spiwocoal/547452/img/pcb3d-1.png

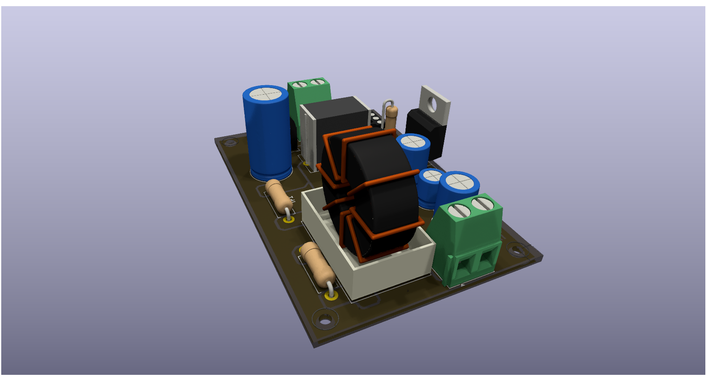
img/pcb3d-1.png
