spiwocoal/547452/img/pcb3d-2.png

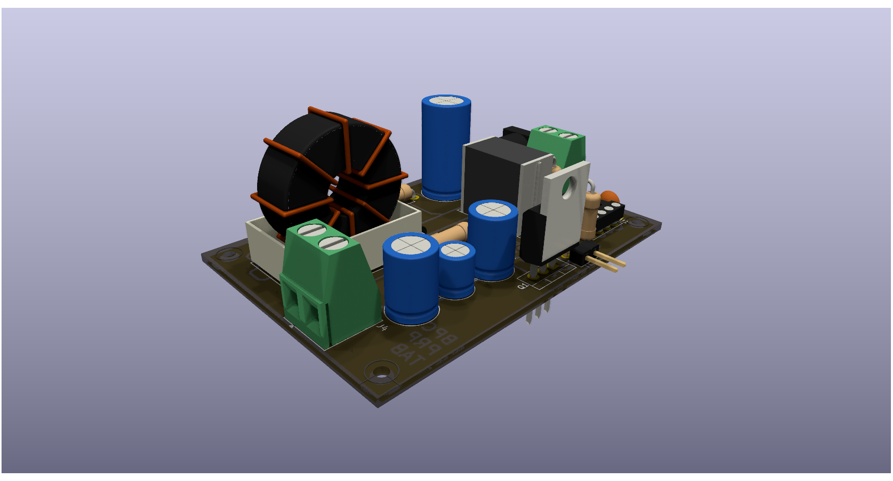
img/pcb3d-2.png
