spiwocoal/547452/esp-src/dpp-qr.png

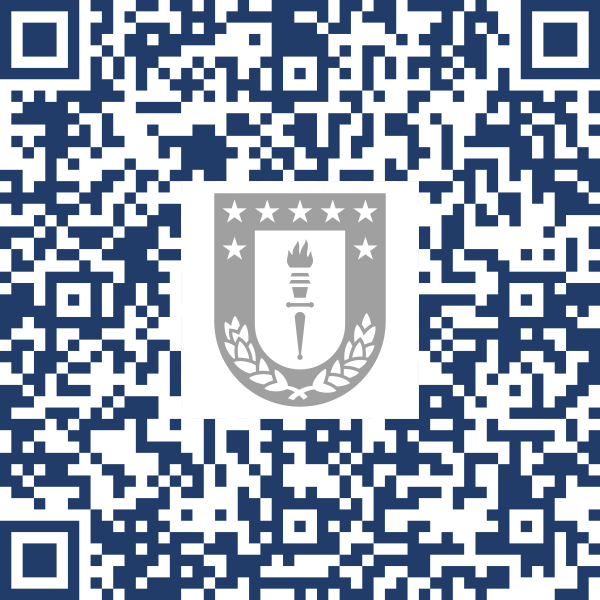
esp-src/dpp-qr.png
