spiwocoal/547452/img/gui.png

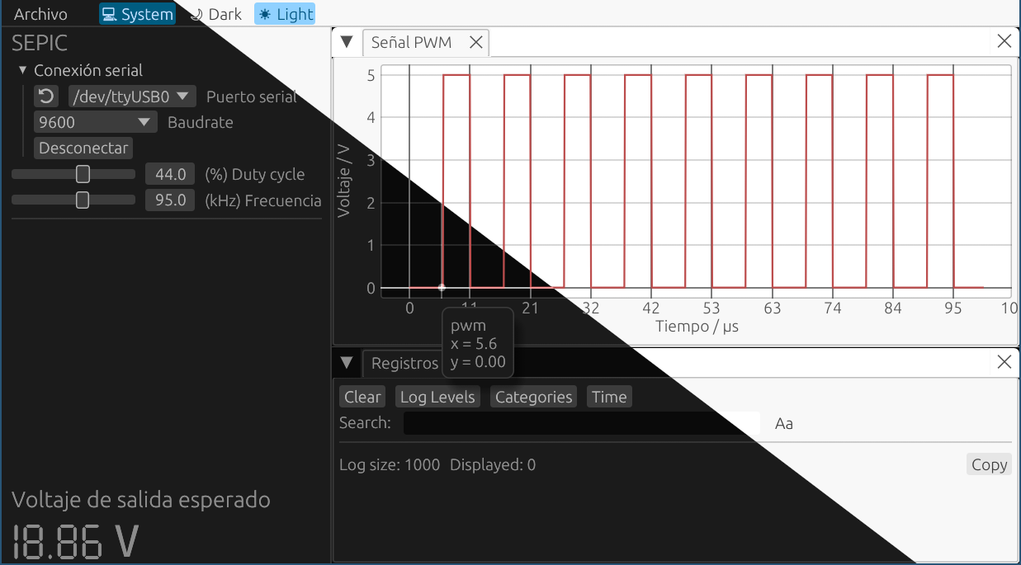
img/gui.png
