spiwocoal/547452/img/pcb3d-3.png

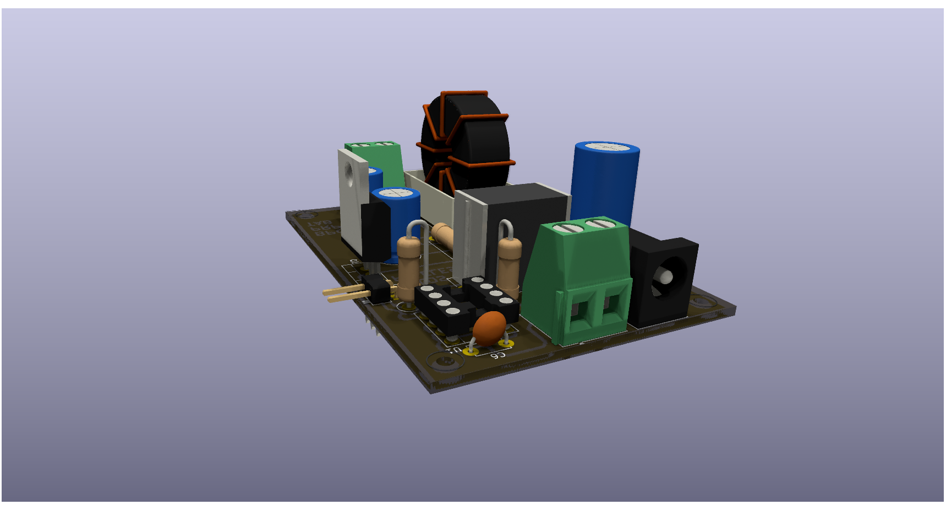
img/pcb3d-3.png
