spiwocoal/547452/img/pcb3d-4.png

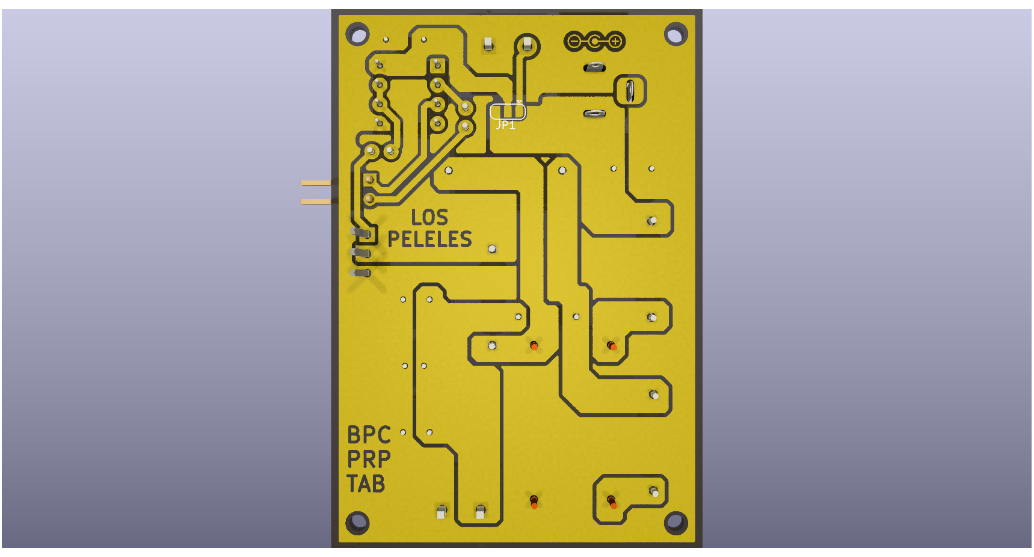
img/pcb3d-4.png
