spiwocoal/547452/spice/plots/duty_ideal.png

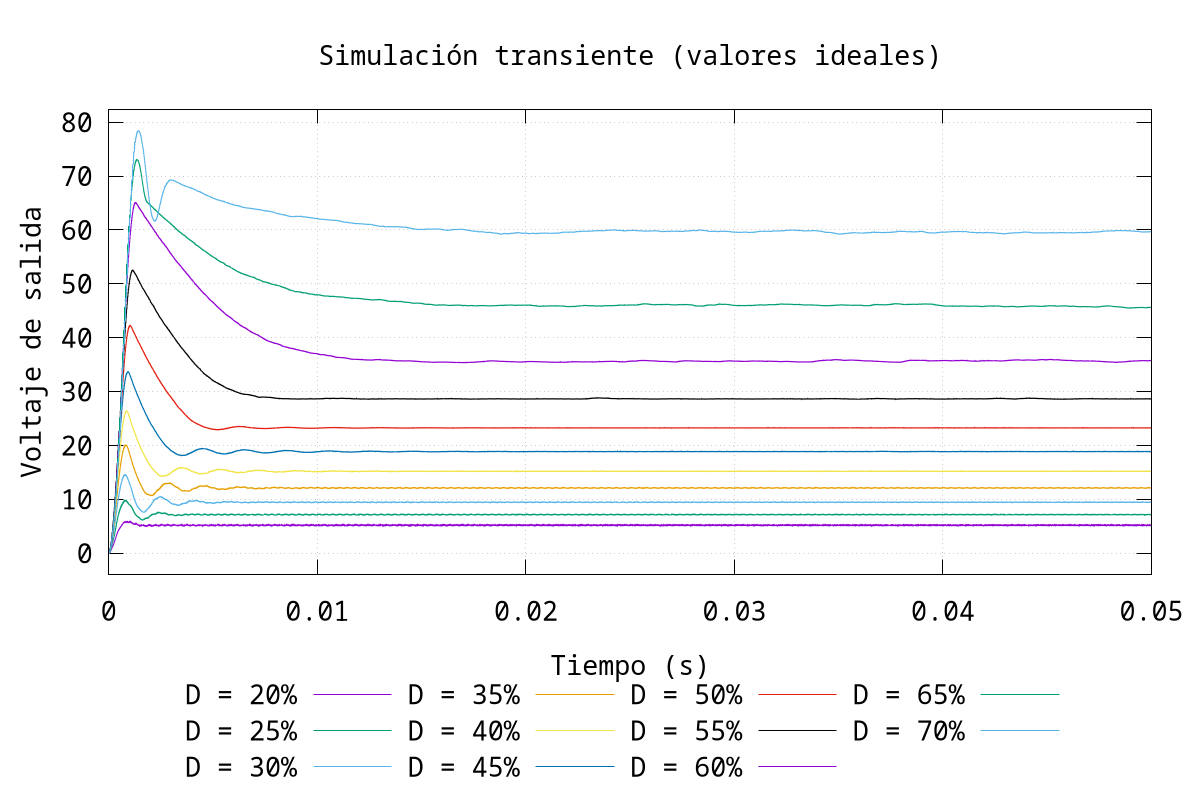
spice/plots/duty_ideal.png
