spiwocoal/547452/spice/plots/duty_med.png

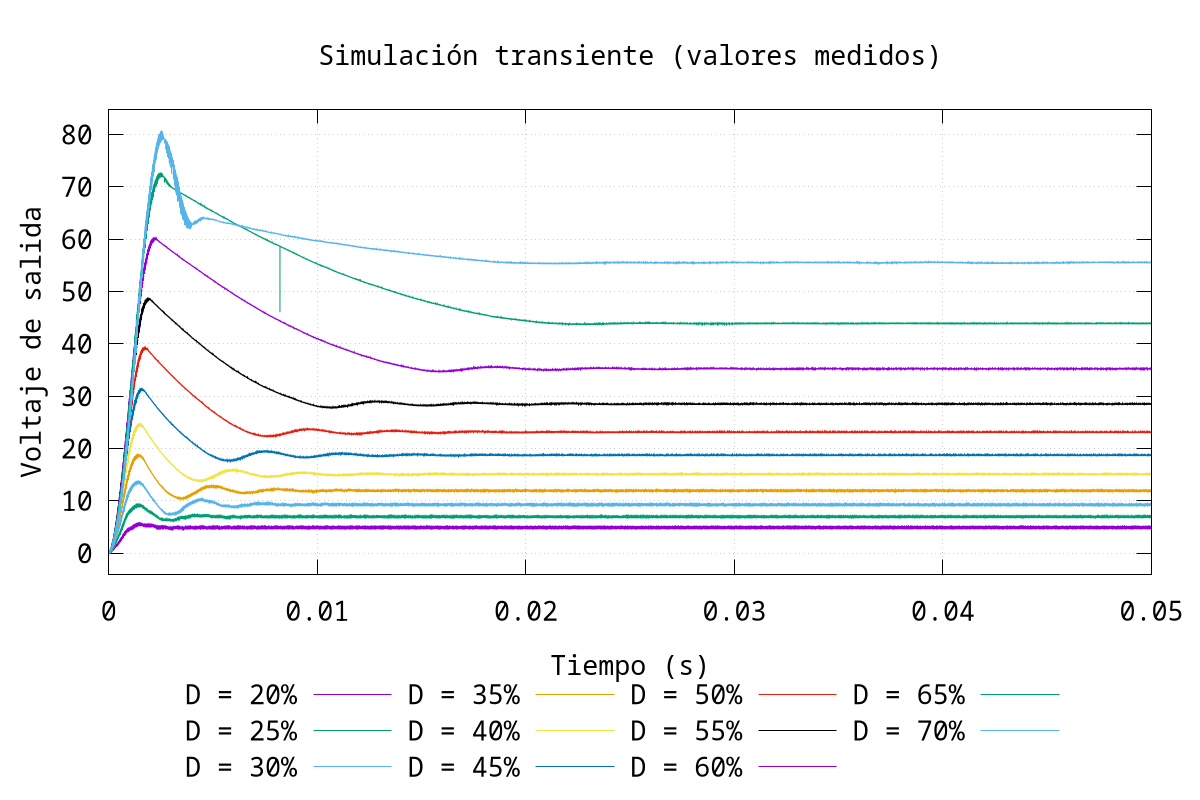
spice/plots/duty_med.png
