spiwocoal/547452/coil-former/airgap-02.stl

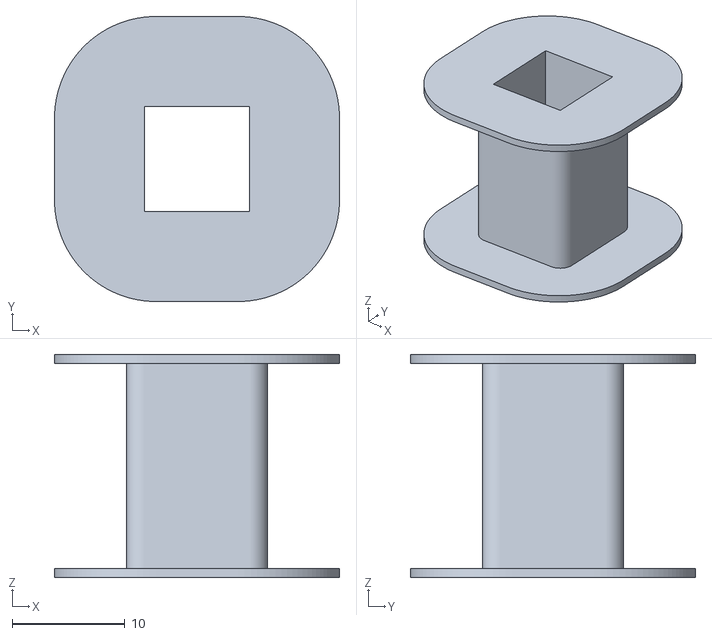
[picture p10: CAD file, 2025-10-09]
coil-former/airgap-02.stl
25.3 x 25.3 x 19.8
