spiwocoal/547452/epicSEPIC/3d-model/enclosure.stl

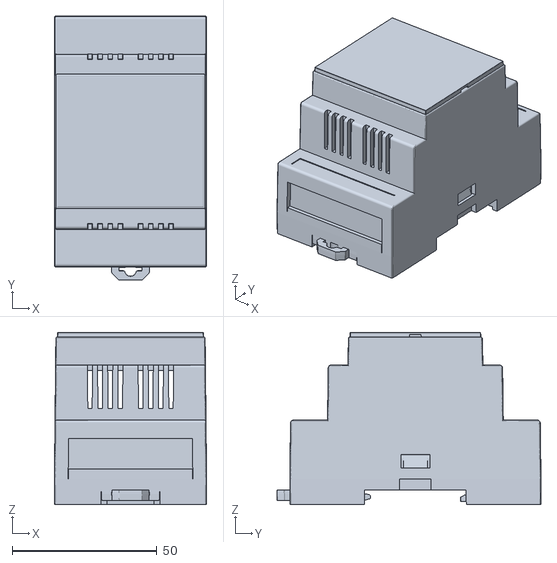
[picture p11: CAD file, 2025-12-04]
epicSEPIC/3d-model/enclosure.stl
52.6 x 91.2 x 59.5
