spiwocoal/547452/SEPIC/gerber/SEPIC-drl_map.dxf

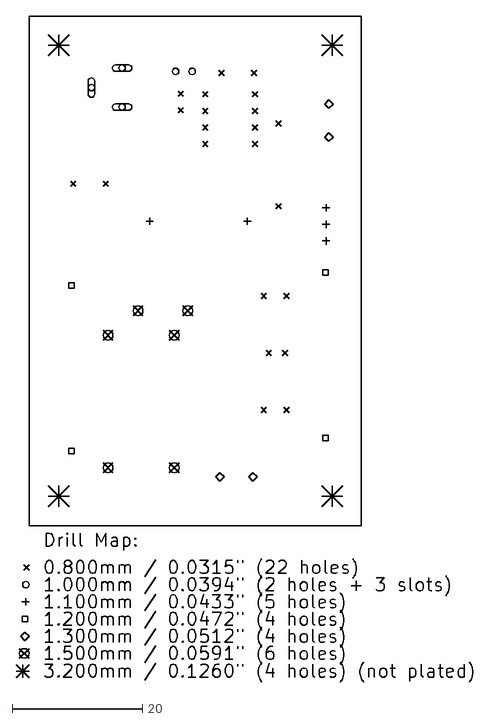
[picture p12: CAD file, 2025-10-24]
SEPIC/gerber/SEPIC-drl_map.dxf
70.1 x 102.3
