spiwocoal/547452/coil-former/split-airgap-02.stl

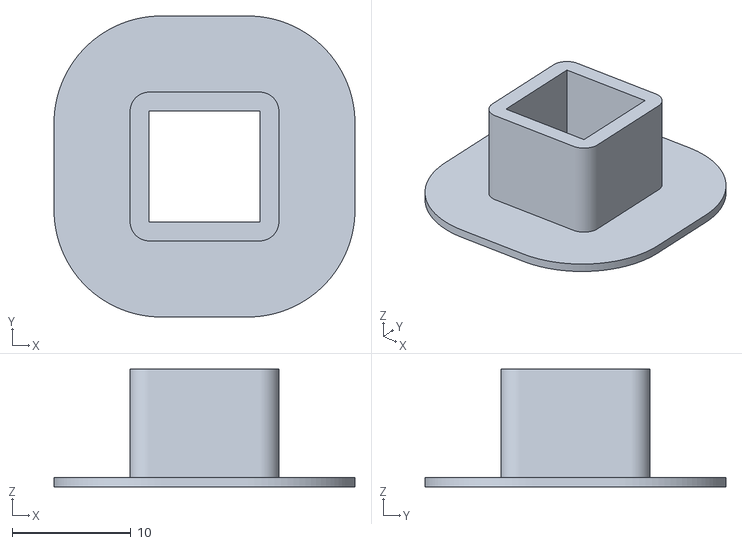
[picture p13: CAD file, 2025-10-09]
coil-former/split-airgap-02.stl
25.3 x 25.3 x 9.90
