spiwocoal/547452/coil-former/split-airgap-04.stl

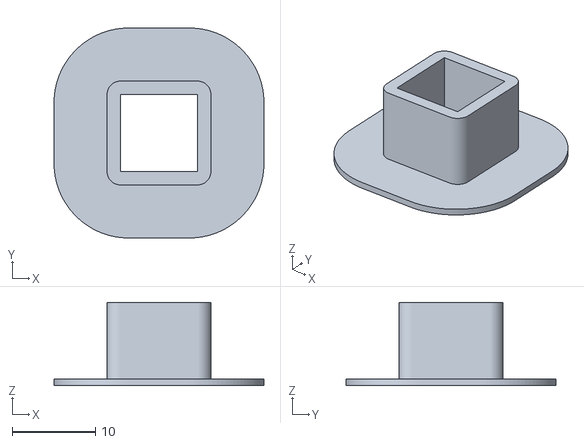
[picture p14: CAD file, 2025-10-09]
coil-former/split-airgap-04.stl
25.3 x 25.3 x 10.00
