spiwocoal/547452/coil-former/split-airgap-0.stl

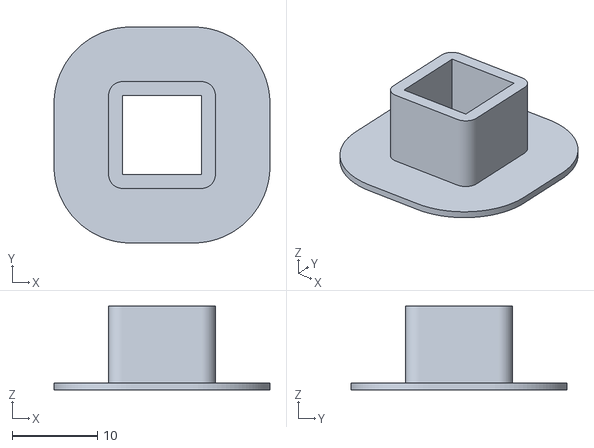
[picture p15: CAD file, 2025-10-09]
coil-former/split-airgap-0.stl
25.3 x 25.3 x 9.80
