spiwocoal/547452/coil-former/airgap-04.stl

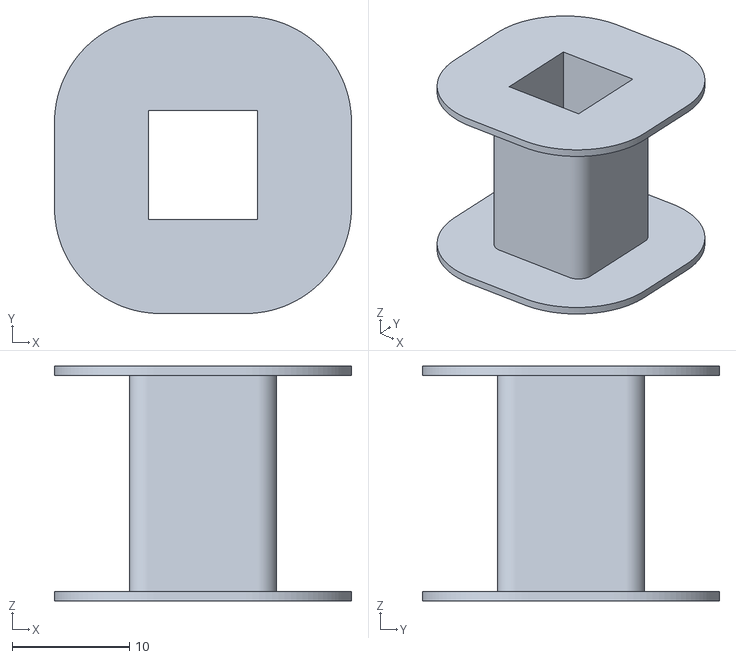
[picture p16: CAD file, 2025-10-09]
coil-former/airgap-04.stl
25.3 x 25.3 x 20.0
