spiwocoal/547452/coil-former/split-airgap-06.stl

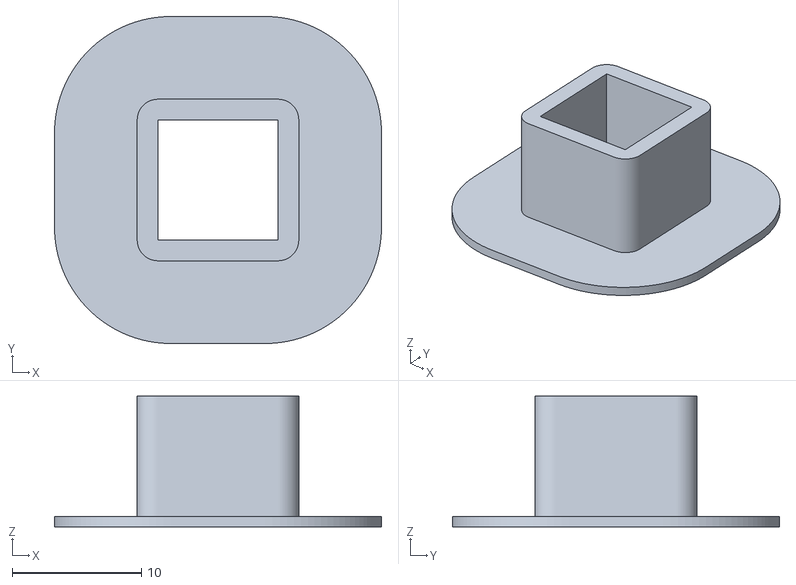
[picture p17: CAD file, 2025-10-09]
coil-former/split-airgap-06.stl
25.3 x 25.3 x 10.1
