spiwocoal/547452/(list of files, cad)

Other CAD files:
coil-former/airgap-0.stl
coil-former/airgap-06.stl
