spiwocoal/547452/schematic.pdf

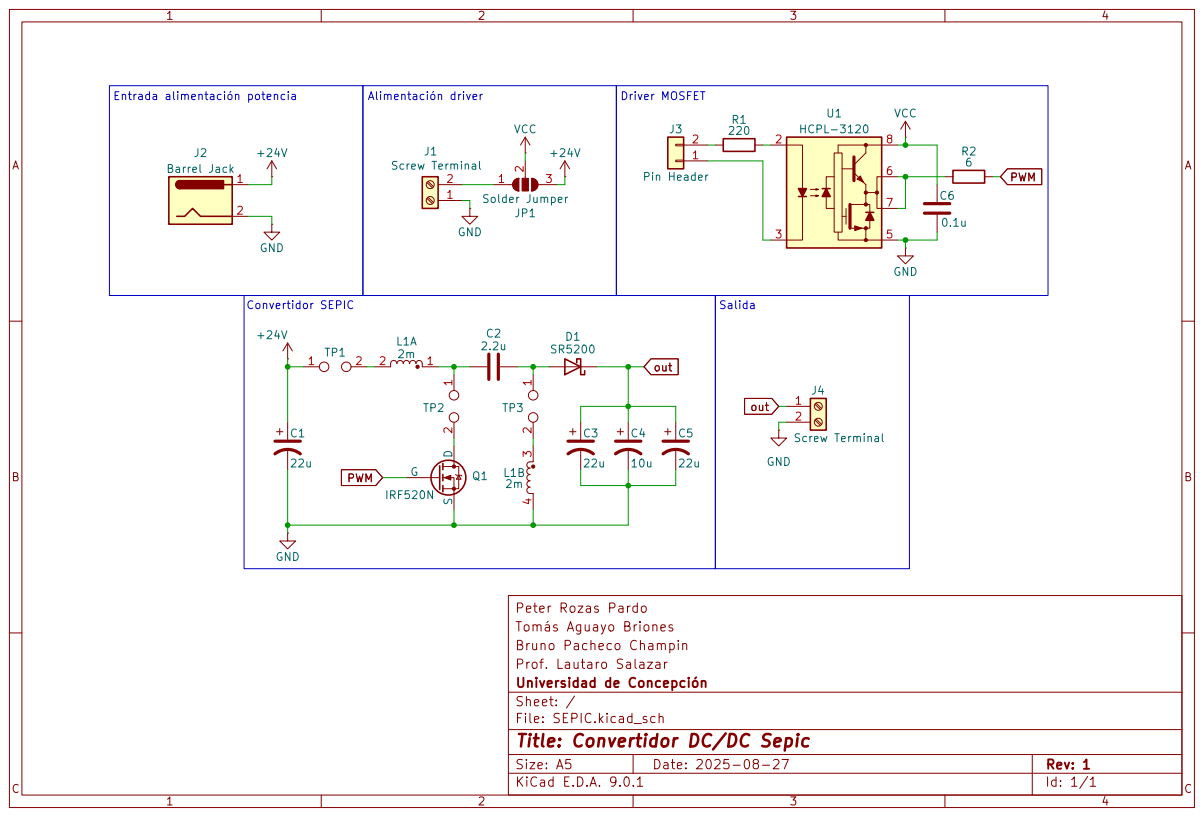
[picture p18: page 1]
