spiwocoal/547452/epicSEPIC/epicSEPIC.kicad_pcb

## KiCad design epicSEPIC/epicSEPIC.kicad_pcb (2025-12-18)

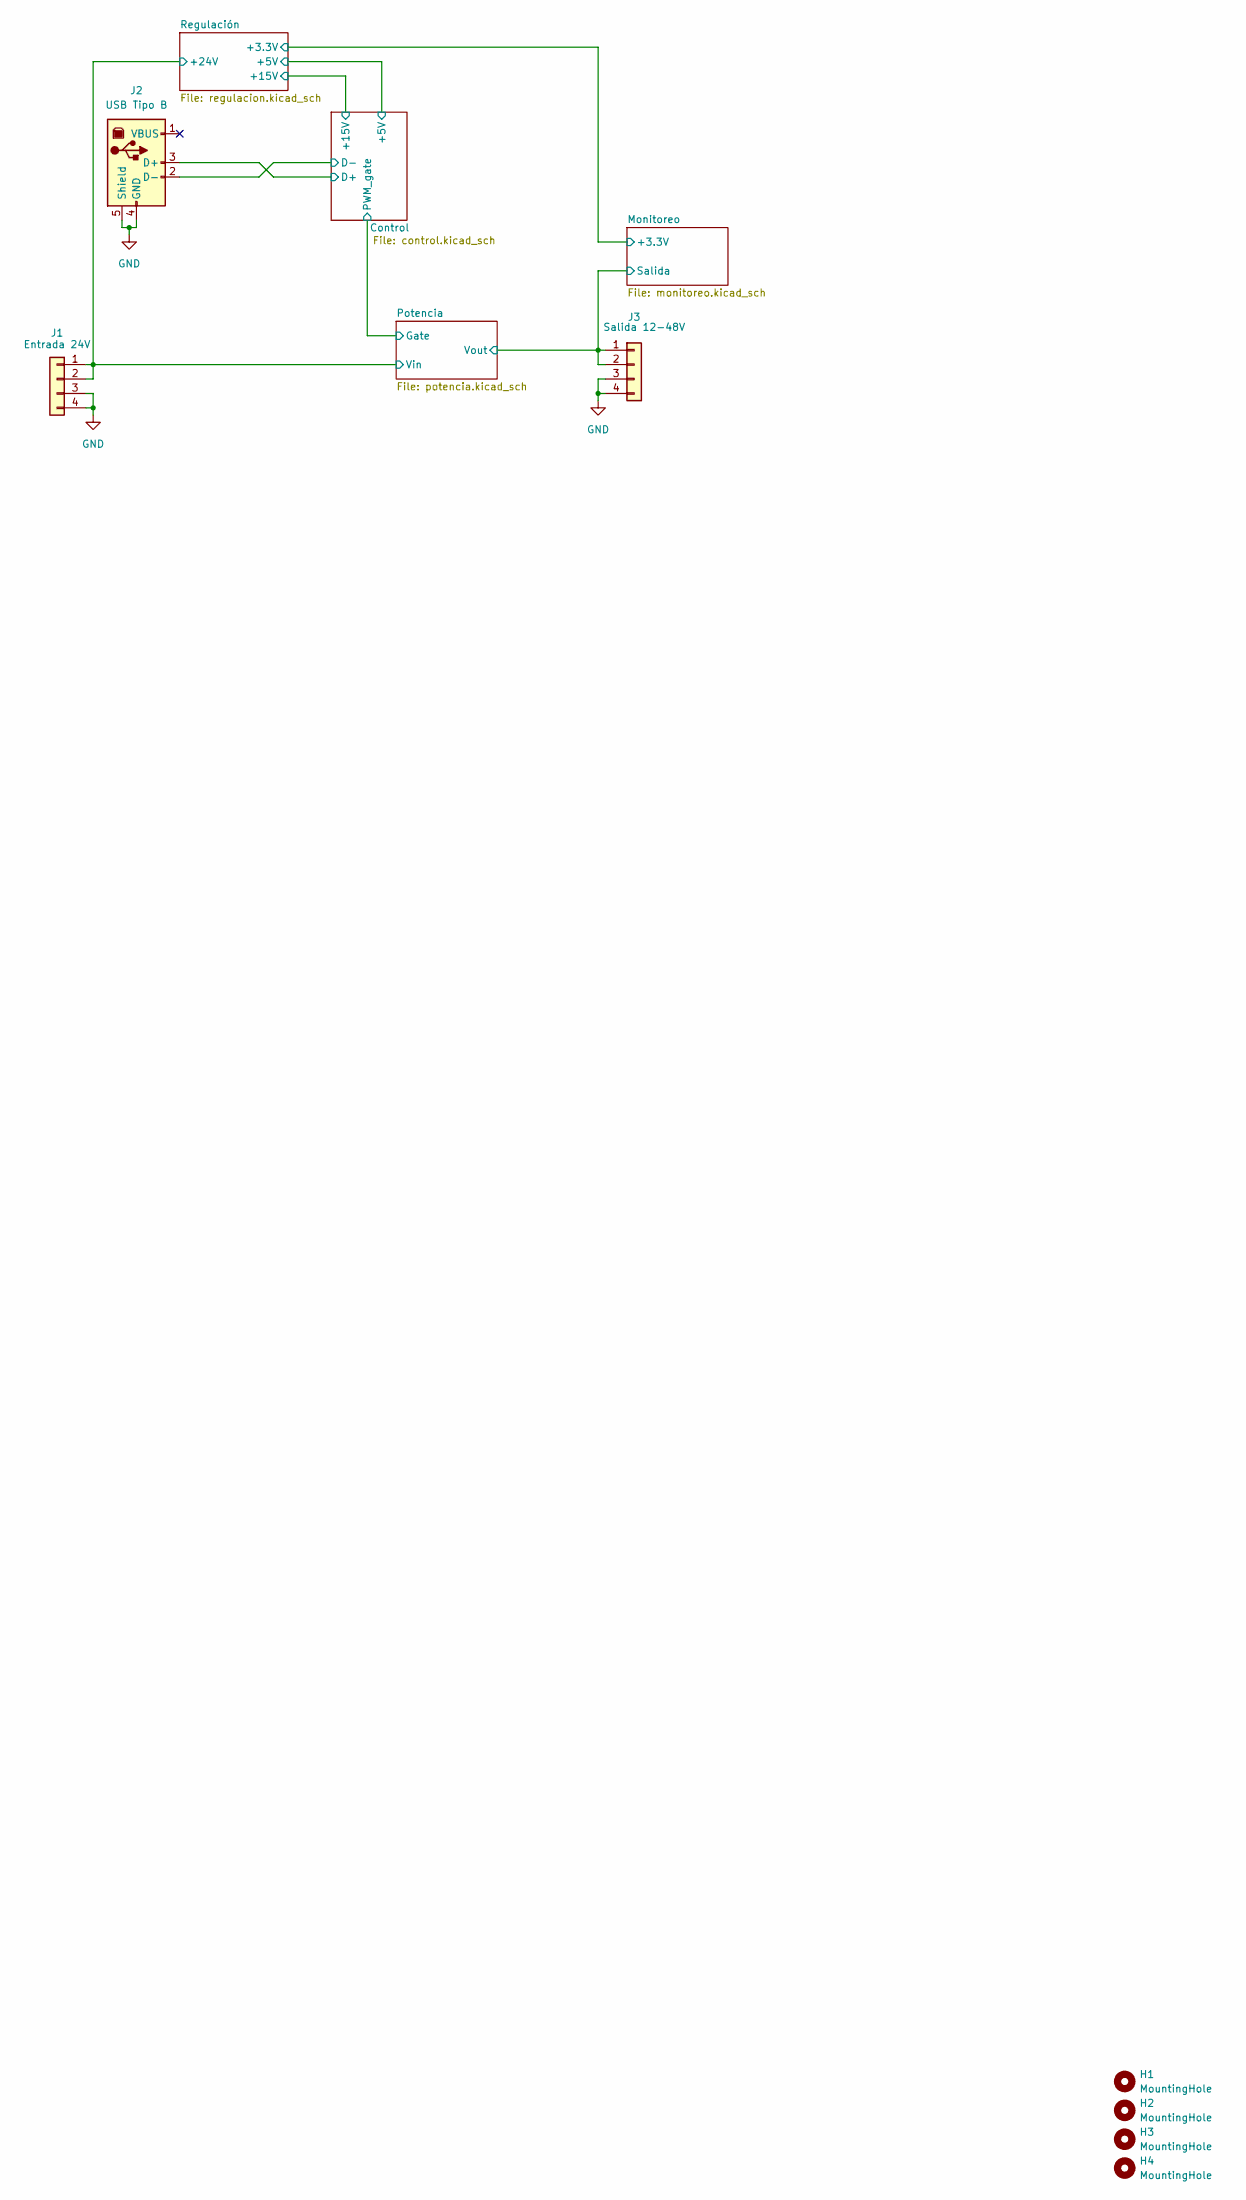
[picture p19: schematic epicSEPIC.kicad_sch]

Parts:
H1, H2, H3, H4: MountingHole; MountingHole_3.2mm_M3_ISO14580
J1: Entrada 24V; 1822752; MfgPN 1823638
J2: USB Tipo B; USB_B_Lumberg_2411_02_Horizontal; MfgPN 61729-0010RLF
J3: Salida 12-48V; 1822752; MfgPN 1823638

Connections:
/Control/D+: J2.3 (D+); also elsewhere on the board
/Control/D-: J2.2 (D-); also elsewhere on the board
/Monitoreo/Salida: J3.1, J3.2; also elsewhere on the board
/Potencia/Vin: J1.1, J1.2; also elsewhere on the board
GND: J1.3, J1.4, J2.4 (GND), J2.5 (Shield), J3.3, J3.4; also elsewhere on the board

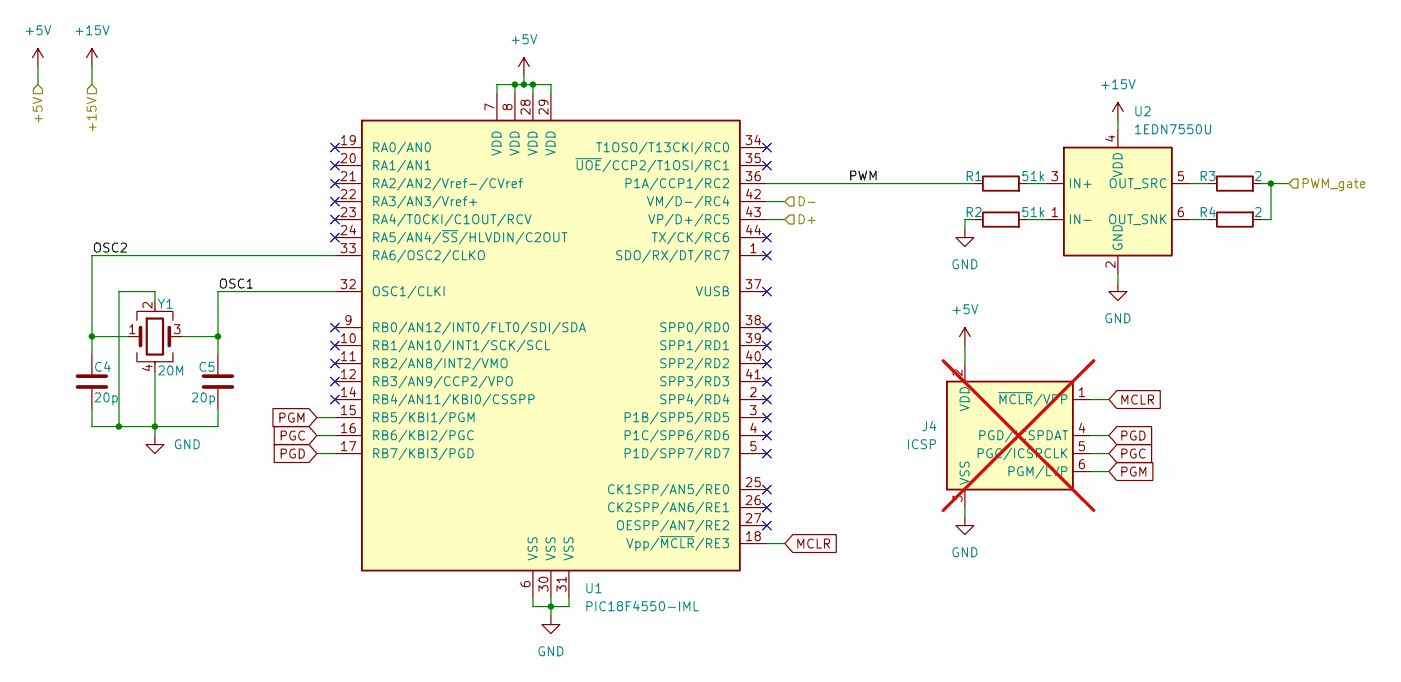
[picture p20: schematic control.kicad_sch]

Parts:
C4, C5: 20p; C_0402_1005Metric; MfgPN C0402C200M8HACTU
J4: ICSP; PinSocket_1x06_P1.00mm_Vertical; not fitted
R1, R2: 51k; R_0603_1608Metric; MfgPN ESR03EZPD5102
R3, R4: 2; R_0402_1005Metric; MfgPN RT0402BRE072RL
U1: PIC18F4550-IML; QFN-44-1EP_8x8mm_P0.65mm_EP6.45x6.45mm; MfgPN PIC18F4550-IML
U2: 1EDN7550U; PG-TSNP-6-13; MfgPN 1EDN7550U
Y1: 20M; Crystal_SMD_2520-4Pin_2.5x2.0mm; MfgPN FH2000021

Connections:
+5V: J4.2 (VDD), U1.7 (VDD), U1.8 (VDD), U1.28 (VDD), U1.29 (VDD); also elsewhere on the board
+15V: U2.4 (VDD); also elsewhere on the board
/Control/D+: U1.43 (VP/D+/RC5); also elsewhere on the board
/Control/D-: U1.42 (VM/D-/RC4); also elsewhere on the board
/Control/OSC1: C5.2, U1.32 (OSC1/CLKI), Y1.3
/Control/OSC2: C4.1, U1.33 (RA6/OSC2/CLKO), Y1.1
/Control/PWM: R1.1, U1.36 (P1A/CCP1/RC2)
/Control/PWM_gate: R3.2, R4.2; also elsewhere on the board
GND: C4.2, C5.1, J4.3 (VSS), R2.1, U1.6 (VSS), U1.30 (VSS), U1.31 (VSS), U2.2 (GND), Y1.2, Y1.4; also elsewhere on the board
MCLR: J4.1 (~MCLR/VPP), U1.18 (Vpp/~MCLR/RE3)
unnamed: R1.2, U2.3 (IN+)
unnamed: R2.2, U2.1 (IN-)
unnamed: R4.1, U2.6 (OUT_SNK)
unnamed: R3.1, U2.5 (OUT_SRC)
PGC: J4.5 (PGC/ICSPCLK), U1.16 (RB6/KBI2/PGC)
PGD: J4.4 (PGD/ICSPDAT), U1.17 (RB7/KBI3/PGD)
PGM: J4.6 (PGM/LVP), U1.15 (RB5/KBI1/PGM)

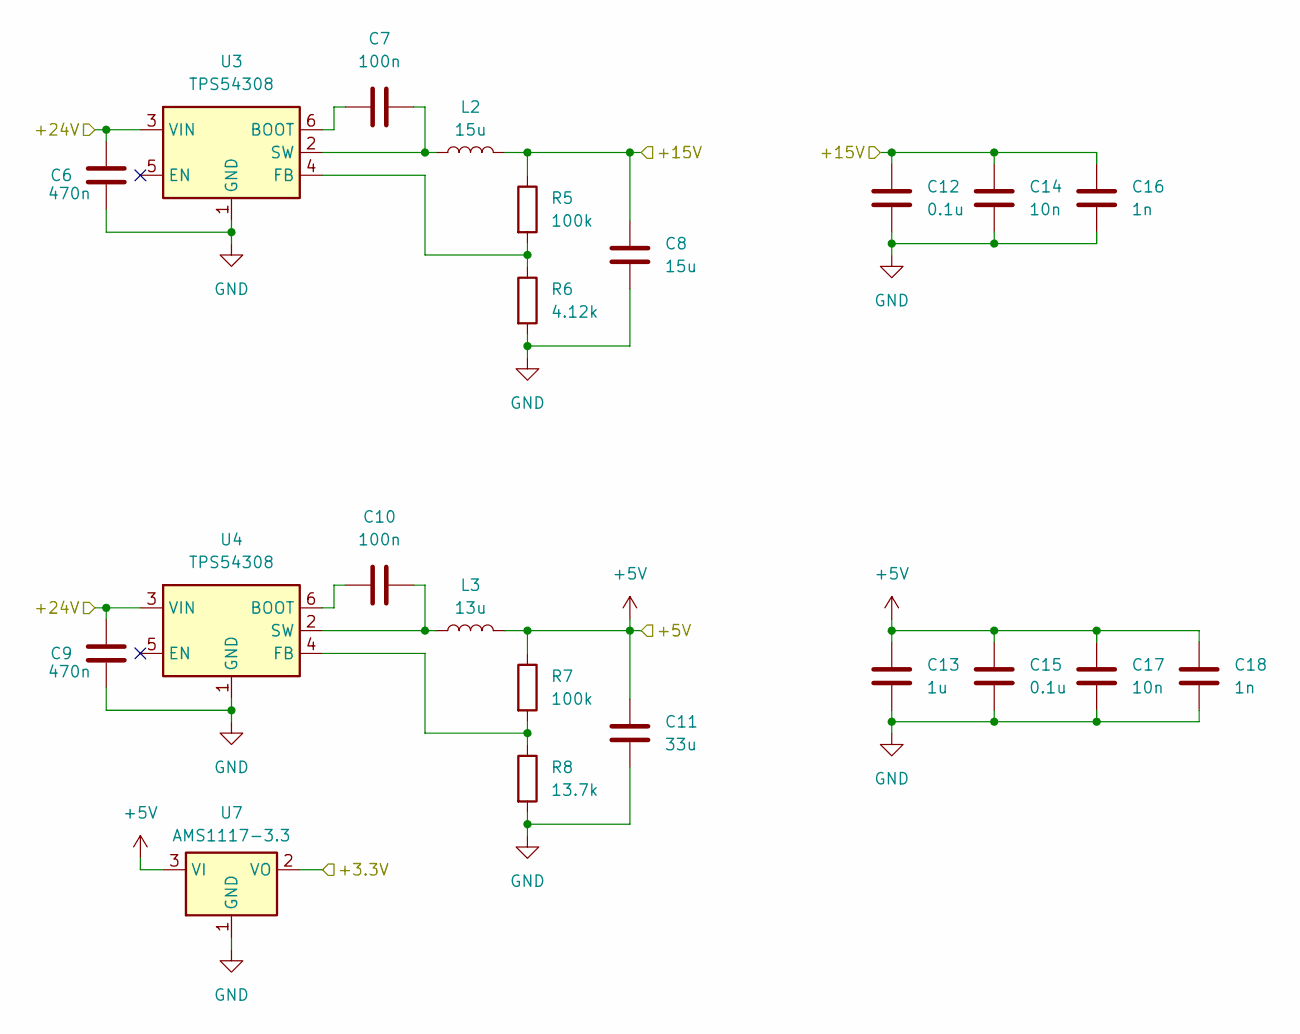
[picture p21: schematic regulacion.kicad_sch]

Parts:
C6, C9: 470n; C_0603_1608Metric; MfgPN CGA3E3X5R1V474K080AB
C7, C10: 100n; C_0402_1005Metric; MfgPN C1005X7R1H104K050BB
C8: 15u; C_0805_2012Metric; MfgPN C2012X5R1V156M125AC
C11: 33u; C_0805_2012Metric; MfgPN C2012X5R1A336M125AC
C12: 0.1u; C_0805_2012Metric; MfgPN C0805C104M4RACTU
C13: 1u; C_0805_2012Metric; MfgPN C0805C105M8RACTU
C14: 10n; C_0603_1608Metric; MfgPN C0603C103M4RACTU
C15: 0.1u; C_0805_2012Metric; MfgPN C0805C104M8RACTU
C16: 1n; C_0402_1005Metric; MfgPN C0402C102M4RACTU
C17: 10n; C_0603_1608Metric; MfgPN C0603C103M8RACTU
C18: 1n; C_0402_1005Metric; MfgPN C0402C102M8RACTU
L2: 15u; L_Wurth_WE-LHMI-7050; MfgPN 74437349150
L3: 13u; L_Wurth_WE-PDF-1064; MfgPN 7447798131
R5, R7: 100k; R_0402_1005Metric; MfgPN CRCW0402100KFKED
R6: 4.12k; R_0402_1005Metric; MfgPN CRCW04024K12FKED
R8: 13.7k; R_0402_1005Metric; MfgPN CRCW040213K7FKED
U3, U4: TPS54308; SOT-23-6; MfgPN TPS54308
U7: AMS1117-3.3; SOT-223-3_TabPin2

Connections:
+3.3V: U7.2 (VO); also elsewhere on the board
+5V: C11.2, C13.1, C15.1, C17.1, C18.1, L3.2, R7.1, U7.3 (VI); also elsewhere on the board
+15V: C8.2, C12.1, C14.1, C16.1, L2.2, R5.1; also elsewhere on the board
/Potencia/Vin: C6.1, C9.1, U3.3 (VIN), U4.3 (VIN); also elsewhere on the board
GND: C6.2, C8.1, C9.2, C11.1, C12.2, C13.2, C14.2, C15.2, C16.2, C17.2, C18.2, R6.2, R8.2, U3.1 (GND), U4.1 (GND), U7.1 (GND); also elsewhere on the board
unnamed: C7.1, U3.6 (BOOT)
unnamed: R5.2, R6.1, U3.4 (FB)
unnamed: C7.2, L2.1, U3.2 (SW)
unnamed: C10.1, U4.6 (BOOT)
unnamed: R7.2, R8.1, U4.4 (FB)
unnamed: C10.2, L3.1, U4.2 (SW)

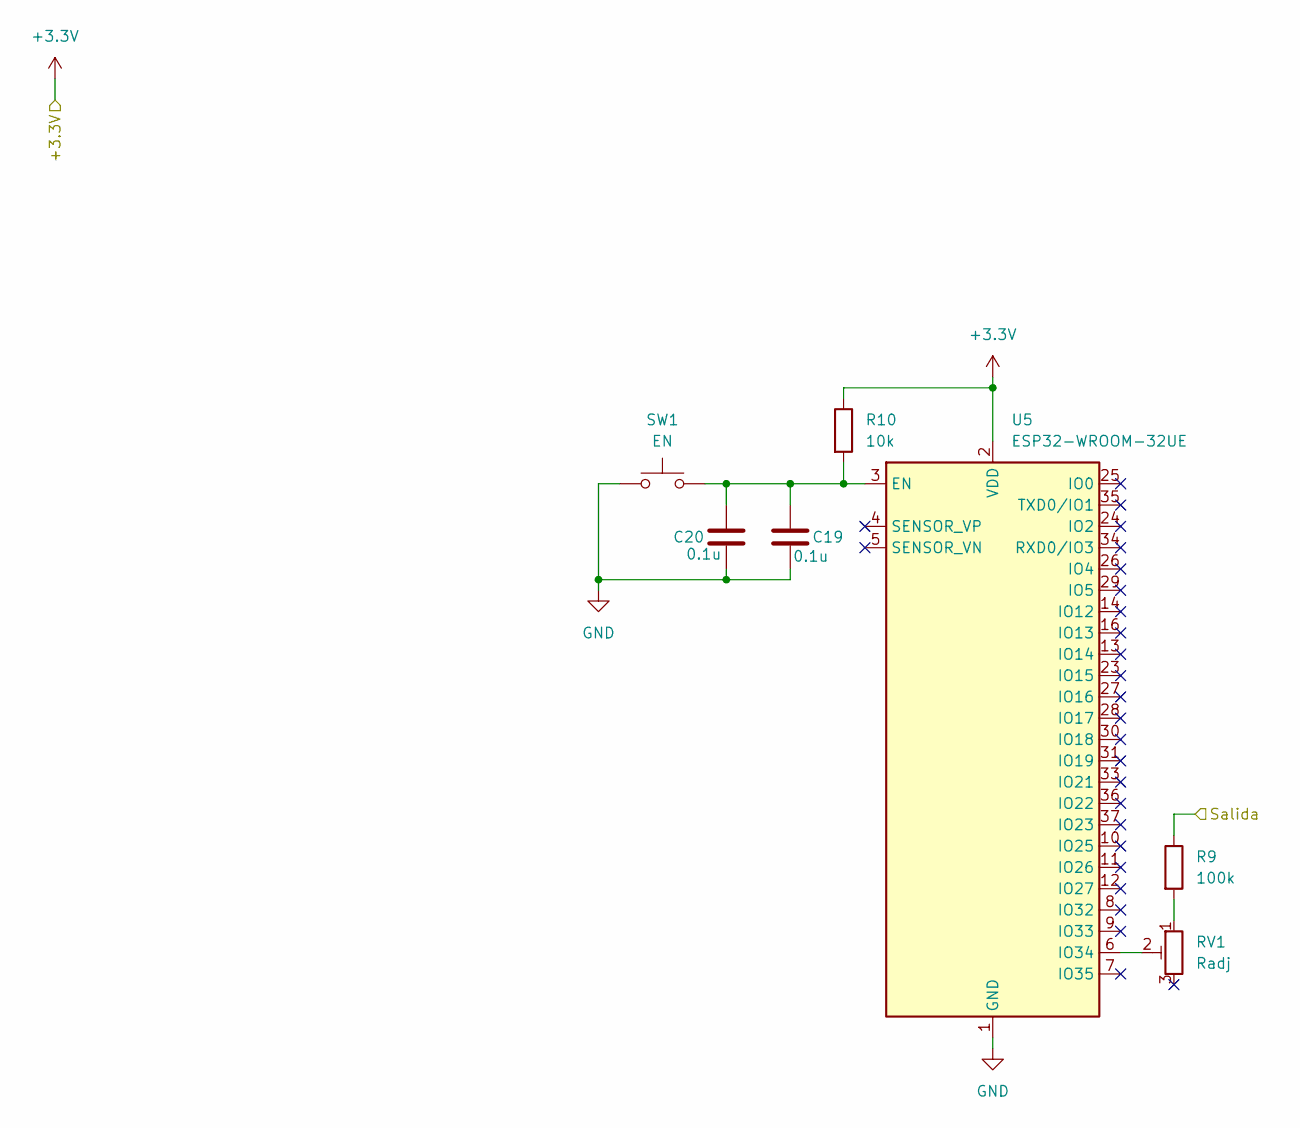
[picture p22: schematic monitoreo.kicad_sch]

Parts:
C19, C20: 0.1u; C_0201_0603Metric
R9: 100k; R_0201_0603Metric
R10: 10k; R_0201_0603Metric
RV1: Radj; 3313J1102E
SW1: EN; SW_SPST_B3U-1000P-B
U5: ESP32-WROOM-32UE

Connections:
+3.3V: R10.1, U5.2 (VDD); also elsewhere on the board
/Monitoreo/Salida: R9.1; also elsewhere on the board
GND: C19.2, C20.2, SW1.1, U5.1 (GND), U5.15 (GND), U5.38 (GND), U5.39 (GND); also elsewhere on the board
unnamed: R9.2, RV1.1
unnamed: C19.1, C20.1, R10.2, SW1.2, U5.3 (EN)
unnamed: RV1.2, U5.6 (IO34)

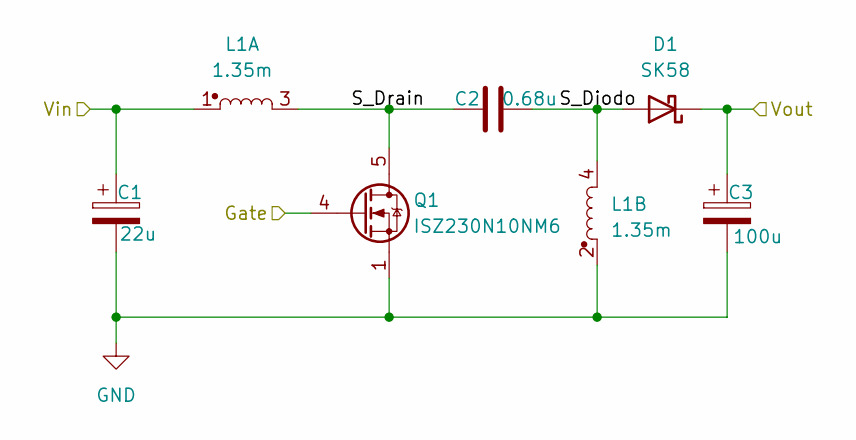
[picture p23: schematic potencia.kicad_sch]

Parts:
C1: 22u; CP_Elec_8x10; MfgPN A767KN226M1HLAE050
C2: 0.68u; C_1206_3216Metric; MfgPN C1206C684M1RACTU
C3: 100u; CP_Elec_10x12.5; MfgPN A767MU107M1JLAE28
D1: SK58; D_SMB; MfgPN SK58
L1: 1.35m; SRF1280680M; MfgPN SRF1280-680M
Q1: ISZ230N10NM6; PG-TSDSON-8-25; MfgPN ISZ230N10NM6ATMA1

Connections:
/Control/PWM_gate: Q1.4 (G); also elsewhere on the board
/Monitoreo/Salida: C3.1, D1.1 (K); also elsewhere on the board
/Potencia/S_Diodo: C2.2, D1.2 (A), L1.4
/Potencia/S_Drain: C2.1, L1.3, Q1.5 (D)
/Potencia/Vin: C1.1, L1.1; also elsewhere on the board
GND: C1.2, C3.2, L1.2, Q1.1 (S); also elsewhere on the board

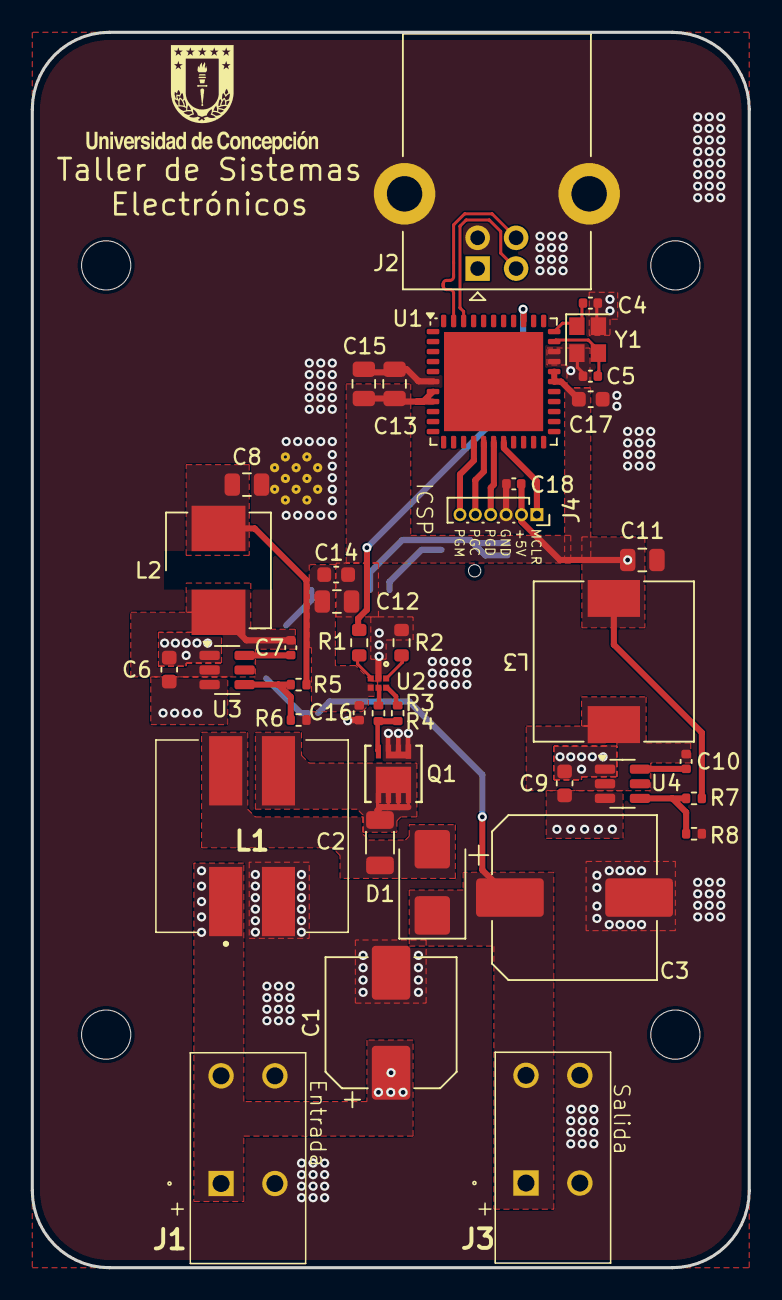
[picture p24: board epicSEPIC.kicad_pcb from above]

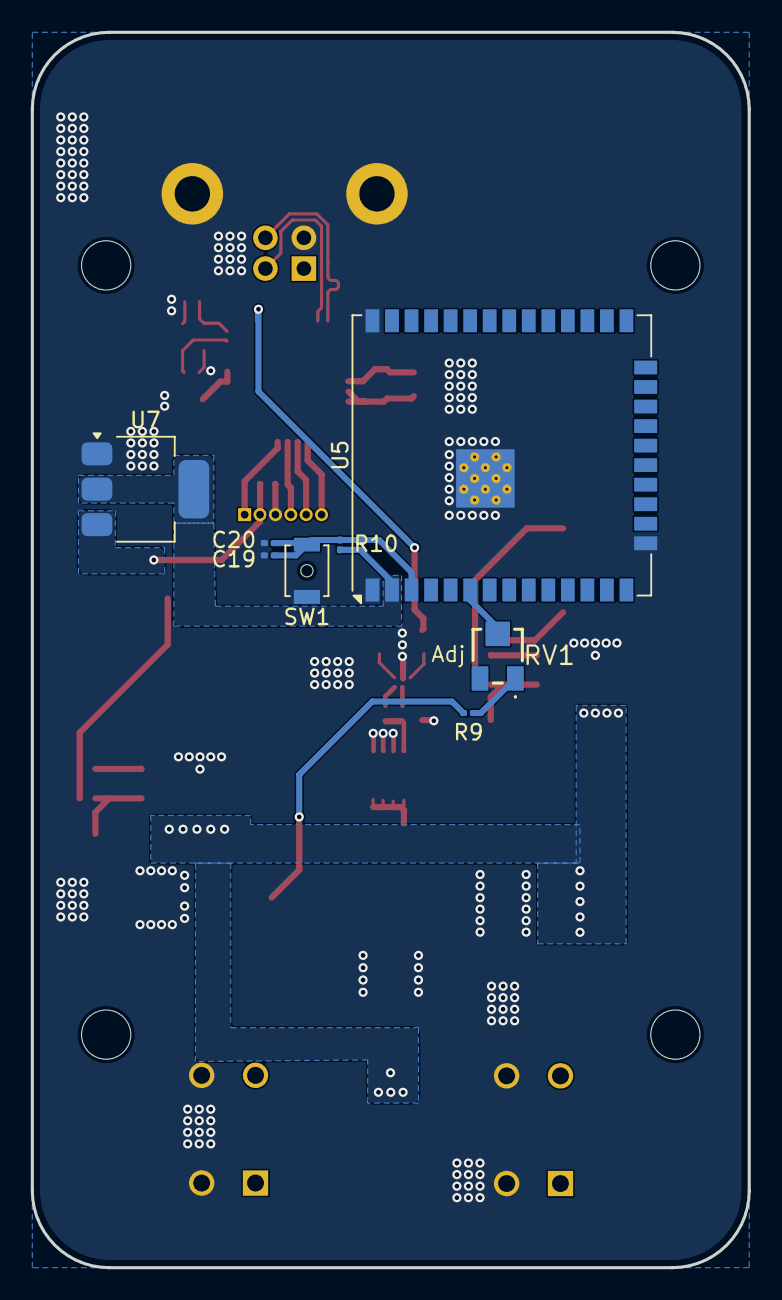
[picture p25: board epicSEPIC.kicad_pcb from below]

Board: 2 copper layers, 46.6 x 80.3 mm, 52 parts (8 on the bottom side), 31 nets.
