spiwocoal/547452/SEPIC/SEPIC.kicad_pcb

## KiCad design SEPIC/SEPIC.kicad_pcb (2025-10-24)

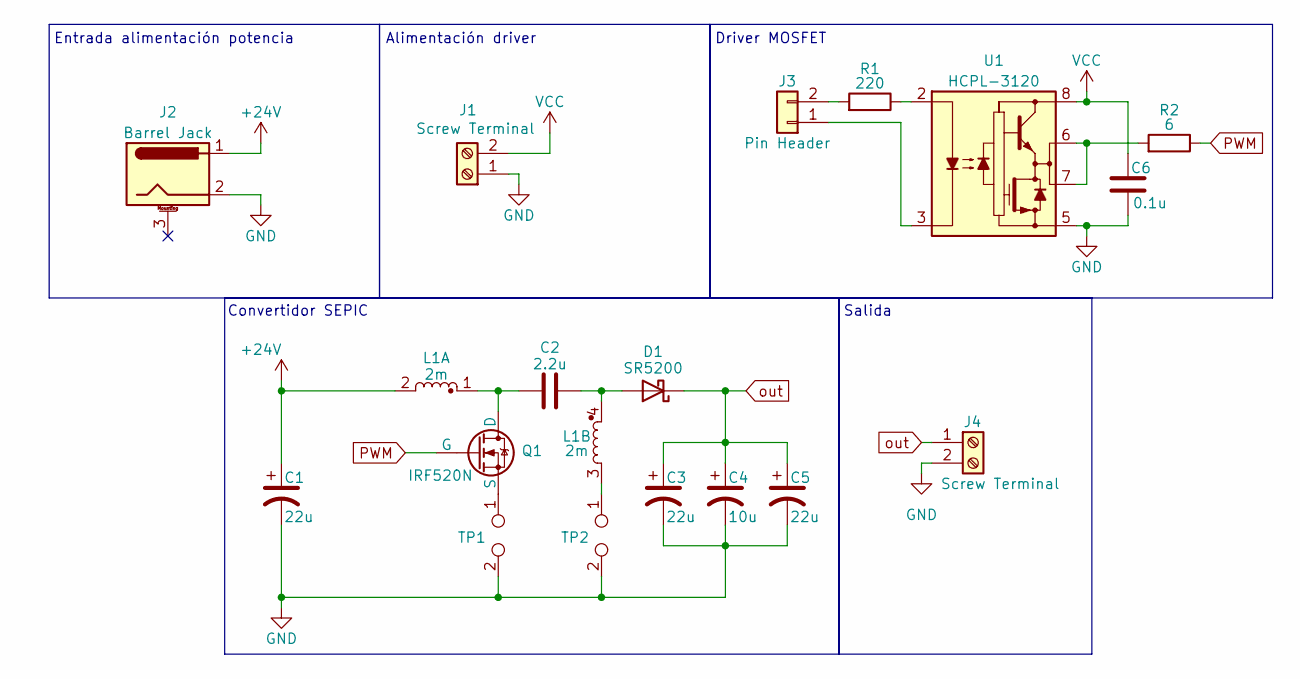
[picture p26: schematic SEPIC.kicad_sch, Convertidor DC/DC Sepic]

Parts:
C1: 22u; C_Radial_D10.0mm_H20.0mm_P5.00mm
C2: 2.2u; C_Rect_L16.5mm_W8.7mm_P15.00mm_MKT
C3, C5: 22u; C_Radial_D8.0mm_H11.5mm_P3.50mm
C4: 10u; C_Radial_D6.3mm_H7.0mm_P2.50mm
C6: 0.1u; C_Disc_D4.7mm_W2.5mm_P5.00mm
D1: SR5200; D_A-405_P7.62mm_Horizontal
J1, J4: Screw Terminal; TerminalBlock_Phoenix_MKDS-1,5-2-5.08_1x02_P5.08mm_Horizont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
J2: Barrel Jack; BarrelJack_Horizontal
J3: Pin Header; PinHeader_1x02_P2.54mm_Vertical
L1: 2m; L_CommonMode_Toroid_Vertical_L24.0mm_W16.3mm_Px10.16mm_Py20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
Q1: IRF520N; TO-220-3_Vertical
R1: 220; R_Axial_DIN0309_L9.0mm_D3.2mm_P2.54mm_Vertical
R2: 6; R_Axial_DIN0309_L9.0mm_D3.2mm_P12.70mm_Horizontal
TP1, TP2: Shunt; R_Axial_DIN0411_L9.9mm_D3.6mm_P25.40mm_Horizontal
U1: HCPL-3120; DIP-8_W7.62mm_Socket

Connections:
+24V: C1.1, J2.1, L1.2
GND: C1.2, C3.2, C4.2, C5.2, C6.2, J1.1, J2.2, J4.2, TP1.2, TP2.2, U1.5 (VEE)
unnamed: C2.2, D1.2 (A), L1.4
unnamed: J3.1, U1.3 (C)
unnamed: J3.2, R1.2
unnamed: L1.3, TP2.1
unnamed: C2.1, L1.1, Q1.2 (D)
unnamed: Q1.3 (S), TP1.1
unnamed: R2.2, U1.6 (VO), U1.7 (VO)
unnamed: R1.1, U1.2 (A)
PWM: Q1.1 (G), R2.1
VCC: C6.1, J1.2, U1.8 (VCC)
out: C3.1, C4.1, C5.1, D1.1 (K), J4.1

Notes on the sheet:
Driver MOSFET
Alimentación driver
Entrada alimentación potencia
Salida
Convertidor SEPIC

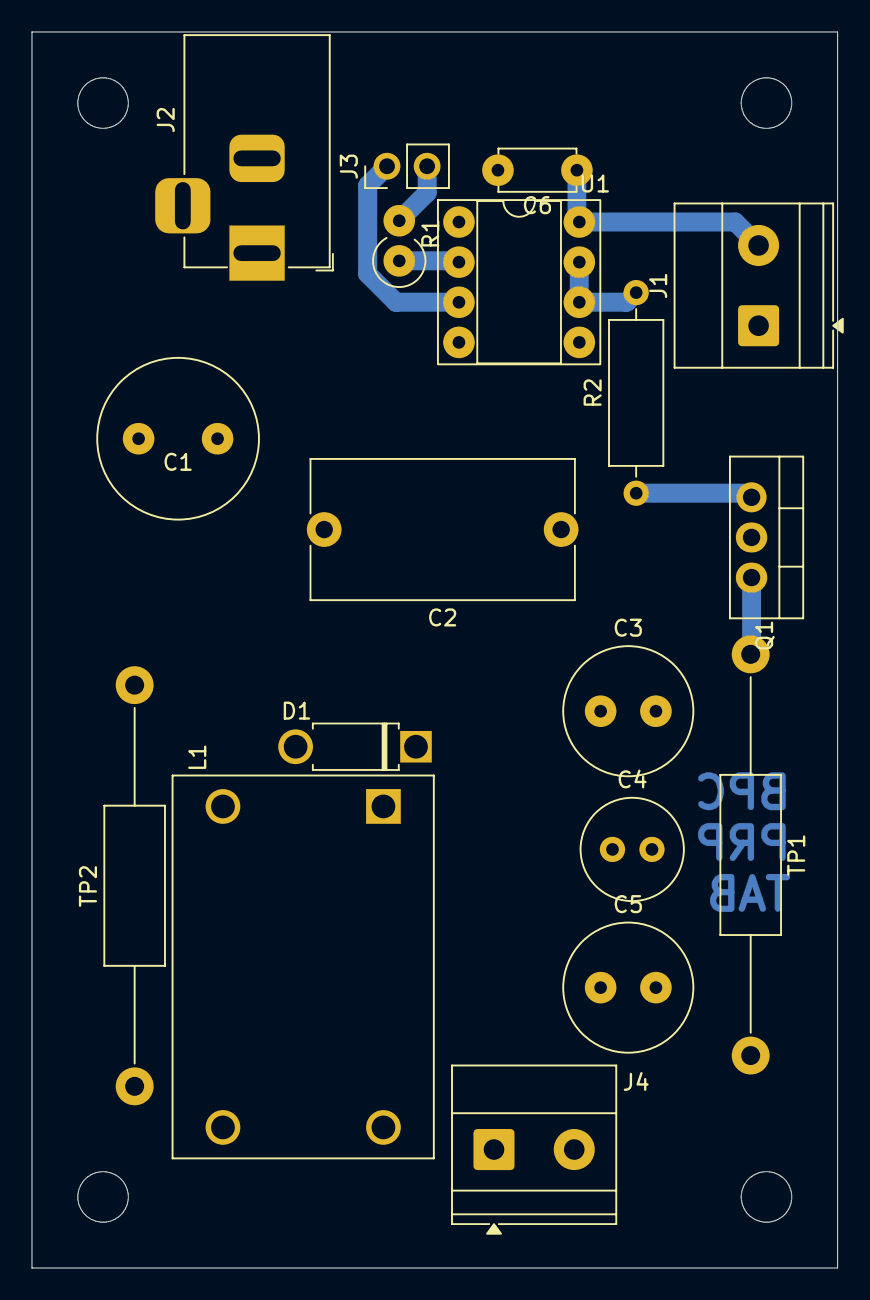
[picture p27: board SEPIC.kicad_pcb from above]

Board: 2 copper layers, 51.0 x 78.2 mm, 18 parts (0 on the bottom side), 13 nets.
