spiwocoal/547452/pic-src/sepic18-usb.X/src/app_sepic_cdc.c

/*******************************************************************************
Copyright 2016 Microchip Technology Inc. (www.microchip.com)

Licensed under the Apache License, Version 2.0 (the "License");
you may not use this file except in compliance with the License.
You may obtain a copy of the License at

    http://www.apache.org/licenses/LICENSE-2.0

Unless required by applicable law or agreed to in writing, software
distributed under the License is distributed on an "AS IS" BASIS,
WITHOUT WARRANTIES OR CONDITIONS OF ANY KIND, either express or implied.
See the License for the specific language governing permissions and
limitations under the License.

To request to license the code under the MLA license (www.microchip.com/mla_license), 
please contact mla_licensing@microchip.com
*******************************************************************************/

/** INCLUDES *******************************************************/
#include "system.h"

#include <stdio.h>
#include <stdint.h>
#include <string.h>
#include <stddef.h>

#include "usb.h"

#include "app_led_usb_status.h"
#include "app_sepic_cdc.h"
#include "usb_config.h"

#include "bsp/pwm.h"

/** VARIABLES ******************************************************/

static uint8_t readBuffer[CDC_DATA_OUT_EP_SIZE];
static uint8_t writeBuffer[CDC_DATA_IN_EP_SIZE];

static freq_t frequency = 60000;
static duty_t duty_cycle = 0;

/*********************************************************************
* Function: void APP_SEPICInitialize(void);
*
* Overview: Initializes application
*
* PreCondition: None
*
* Input: None
*
* Output: None
*
********************************************************************/
void APP_SEPICInitialize()
{   
    line_coding.bCharFormat = 0;
    line_coding.bDataBits = 8;
    line_coding.bParityType = 0;
    line_coding.dwDTERate = 9600;
}

/*********************************************************************
* Function: void APP_SEPICTasks(void);
*
* Overview: Keeps the application running.
*
* PreCondition: The application should have been initialized and started via
*   the APP_SEPICInitialize().
*
* Input: None
*
* Output: None
*
********************************************************************/
void APP_SEPICTasks()
{
    /* If the USB device isn't configured yet, we can't really do anything
     * else since we don't have a host to talk to.  So jump back to the
     * top of the while loop. */
    if( USBGetDeviceState() < CONFIGURED_STATE )
    {
        return;
    }

    /* If we are currently suspended, then we need to see if we need to
     * issue a remote wakeup.  In either case, we shouldn't process any
     * keyboard commands since we aren't currently communicating to the host
     * thus just continue back to the start of the while loop. */
    if( USBIsDeviceSuspended()== true )
    {
        return;
    }

    /* Check to see if there is a transmission in progress, if there isn't, then
     * we can see about performing an echo response to data received.
     */
    if( USBUSARTIsTxTrfReady() == true)
    {
        uint8_t numBytesRead, numBytesWritten;
        char* stx;
        char* tok;
        
        uint32_t arg0, arg1, arg2;

        numBytesRead = getsUSBUSART(readBuffer, sizeof(readBuffer));
        
        if(numBytesRead > 0)
        {
            stx = readBuffer;

            while ((stx = strchr(stx, 0x02)) != NULL) {
                tok = strtok(++stx, " \x03");
                if (!strcmp(tok, "\x05")) {
                    numBytesWritten = sprintf(writeBuffer, "\x06\x02");
                    numBytesWritten += sprintf(writeBuffer + numBytesWritten, "FRQ %lx\x03\x02", frequency);
                    numBytesWritten += sprintf(writeBuffer + numBytesWritten, "DTY %x\x03", duty_cycle);
                } else if (!strcmp(tok, "DCS")) {
                    tok = strtok(NULL, " \x03");
                    sscanf(tok, "%lx", &arg0);
                    duty_cycle = (duty_t)arg0;
                    pwm_set_dutycycle((duty_t)arg0, frequency);
                    numBytesWritten = sprintf(writeBuffer, "\x06 DCS %x", (duty_t)arg0);
                } else if (!strcmp(tok, "FQS")) {
                    tok = strtok(NULL, " \x03\0");
                    sscanf(tok, "%llx", &arg0);
                    frequency = (freq_t)arg0;
                    pwm_set_frequency(frequency);
                    pwm_set_dutycycle(duty_cycle, frequency);
                    numBytesWritten = sprintf(writeBuffer, "\x06 FQS %lx", (freq_t)arg0);
                } else if (!strcmp(tok, "DCR")) {
                    tok = strtok(NULL, " \x03\0");
                    sscanf(tok, "%llx", &arg0);
                    tok = strtok(NULL, " \x03\0");
                    sscanf(tok, "%llx", &arg1);
                    tok = strtok(NULL, " \x03\0");
                    sscanf(tok, "%llx", &arg2);
                    pwm_interp_dutycycle((duty_t)arg0, (duty_t)arg1, (time_t)(arg2), frequency);
                    numBytesWritten = sprintf(writeBuffer, "\x06 DCR %x %x %lx", (duty_t)arg0, (duty_t)arg1, (time_t)arg2);
                } else {
                    strcpy(writeBuffer, "\x15");
                }
            }
            
            putUSBUSART(writeBuffer,numBytesWritten);
        }   
    }
    
    duty_cycle = PWMTasks(frequency, duty_cycle);

    CDCTxService();
}
