spiwocoal/547452/(commit log)

2025-08-28 Placa v0.1
    [SEPIC.kicad_pcb, SEPIC.kicad_sch]
2025-08-30 Diseño de PCB finalizado, generación de gerber
    [SEPIC.kicad_pcb, SEPIC.kicad_sch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]
2025-08-31 Arreglar pines MOSFET
    [SEPIC.kicad_pcb, SEPIC.kicad_sch]
2025-09-01 Agregar graficos a PCB
    [SEPIC.kicad_pcb]
2025-09-01 WIP: redimensionar componentes PCB
    [SEPIC.kicad_pcb, SEPIC.kicad_sch]
2025-09-02 PCB aprobada por Seba
    [SEPIC.kicad_pcb]
2025-09-03 Agregar testpoints corriente PCB
    [SEPIC.kicad_pcb, SEPIC.kicad_sch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]
2025-09-08 Agregar puntos medición corriente
    [SEPIC.kicad_pcb, SEPIC.kicad_sch]
2025-09-09 Condensadores salida
    [SEPIC-drl_map.dxf, SEPIC.kicad_pcb, SEPIC.kicad_sch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]
2025-09-09 Simulacion con valores medidos
    [SEPIC.kicad_sch]
2025-09-11 Cambiar tamaño perforaciones
    [SEPIC.kicad_pcb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]
2025-09-11 Agregar carpeta para PIC
2025-09-25 Imagenes PCB
    [SEPIC.kicad_pcb, SEPIC.kicad_sch]
2025-10-09 Agregar proyecto MPLAB
    [configuration_bits.h]
2025-10-09 Agregar modelo 3D coil former
    [airgap-0.stl, airgap-02.stl, airgap-04.stl, airgap-06.stl, coilformer.scad, split-airgap-0.stl, split-airgap-02.stl, split-airgap-04.stl]
2025-10-20 WIP: PCB producto final
    [epicSEPIC.kicad_pcb, epicSEPIC.kicad_sch]
2025-10-24 PCB prototipo mejorado
    [SEPIC-drl_map.dxf, SEPIC.kicad_pcb, SEPIC.kicad_sch, epicSEPIC.kicad_pcb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]
2025-10-27 Agregar repo para GUI
2025-11-05 pic18: librería para pwm y adc
    [configuration_bits.h]
2025-11-16 Ordenar código nivel 2
    [configuration_bits.h]
2025-11-17 WIP: código PIC18 para interfaz mediante USB
2025-11-18 WIP: rampa duty cycle, tasa de refresco 1ms
2025-11-21 Arreglar tracking de archivos MPLAB con git
2025-11-27 Agregar proyecto de prueba pwm
2025-12-02 Arreglar rampa de duty
    [app_sepic_cdc.c, pwm.c, pwm.h]
2025-12-02 Agregar plantilla para informe
2025-12-03 PCB Final en proceso, encontré el inductor
    [epicSEPIC.kicad_pcb, epicSEPIC.kicad_sch]
2025-12-04 Agregar repo submodulo para informe
    [epicSEPIC.kicad_pcb, epicSEPIC.kicad_sch]
2025-12-04 Diseño de PCB final
    [epicSEPIC.kicad_pcb, epicSEPIC.kicad_sch]
2025-12-04 PCB final
    [control.kicad_sch, enclosure.stl, epicSEPIC.kicad_pcb, epicSEPIC.kicad_sch, potencia.kicad_sch, regulacion.kicad_sch]
2025-12-04 Agregar datasheets
    [control.kicad_sch, epicSEPIC.kicad_pcb, epicSEPIC.kicad_sch, potencia.kicad_sch, regulacion.kicad_sch]
2025-12-07 PCB Final con reguladores
    [epicSEPIC.kicad_pcb, epicSEPIC.kicad_sch, regulacion.kicad_sch]
2025-12-09 Agregar video y fotos modelo 3D
    [control.kicad_sch, epicSEPIC.kicad_sch]
2025-12-09 Actualizar BOM
    [control.kicad_sch, epicSEPIC.kicad_sch, potencia.kicad_sch, regulacion.kicad_sch]
2025-12-09 fixup! Actualizar BOM
2025-12-14 Conexión de interfaz gráfica con ESP-32
2025-12-16 Agregar ESP32 a pcb
    [control.kicad_sch, epicSEPIC.kicad_pcb, epicSEPIC.kicad_sch, monitoreo.kicad_sch, potencia.kicad_sch, regulacion.kicad_sch]
2025-12-16 ESP32 agregado
    [epicSEPIC.kicad_pcb, monitoreo.kicad_sch]
2025-12-18 Arreglar modelos 3D
    [epicSEPIC.kicad_pcb]
